Open-Source-Model-Railway-Electronics/OS-Flux/software/Flux-Mobile/changelog.txt

software
v0.0.0   Date/time:2026-02-01 20:26:24.896815
Project assembled
