Open-Source-Model-Railway-Electronics/OS-Flux/hardware/OS-Flux.kicad_pcb

## KiCad design hardware/OS-Flux.kicad_pcb (2026-11-04)

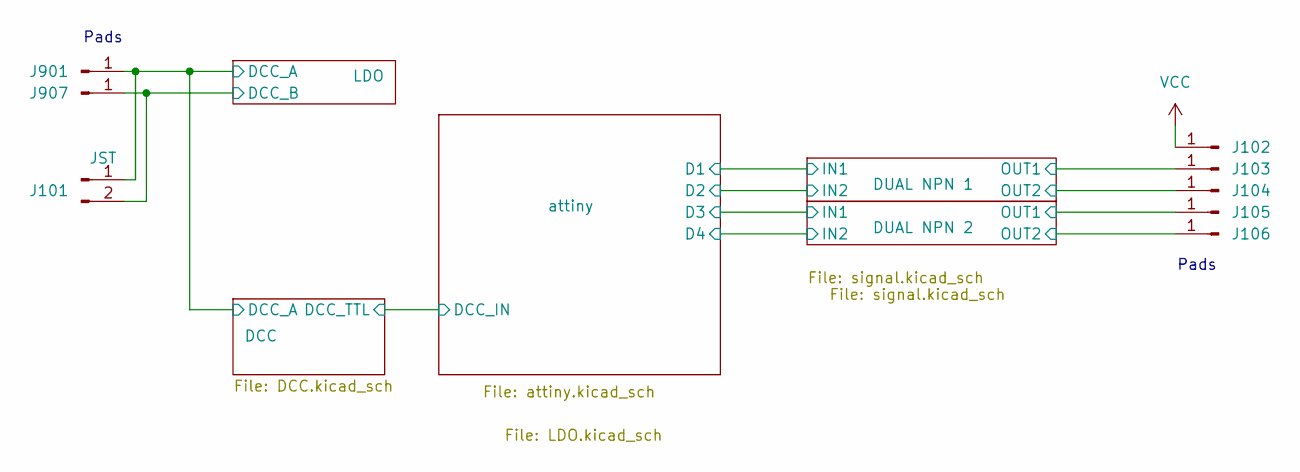
[picture p6: schematic OS-Flux.kicad_sch]

Parts:
J101: JST; JST_SH_SM02B-SRSS-TB_1x02-1MP_P1.00mm_Horizontal
J102, J103, J104, J105, J106, J901, J907: Conn_01x01_Pin; SolderWirePad_1x01_SMD_1x2mm

Connections:
/DCC/DCC_A: J101.1, J901.1; also elsewhere on the board
/DUAL NPN 1/OUT1: J103.1; also elsewhere on the board
/DUAL NPN 1/OUT2: J104.1; also elsewhere on the board
/DUAL NPN 2/OUT1: J105.1; also elsewhere on the board
/DUAL NPN 2/OUT2: J106.1; also elsewhere on the board
/LDO/DCC_B: J101.2, J907.1; also elsewhere on the board
VCC: J102.1; also elsewhere on the board

Notes on the sheet:
Pads

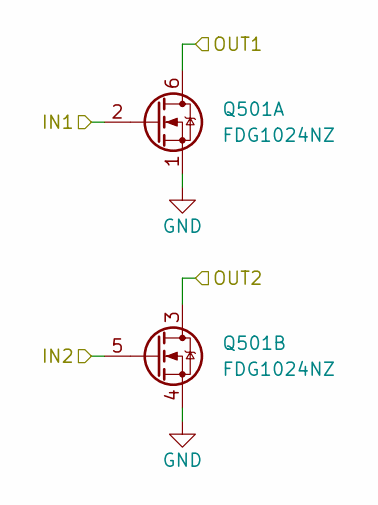
[picture p7: schematic signal.kicad_sch]

Parts:
Q501: FDG1024NZ; SOT-363_SC-70-6; JLCPCB Part# C262138

Connections:
/DUAL NPN 1/IN1: Q501.2 (G); also elsewhere on the board
/DUAL NPN 1/IN2: Q501.5 (G); also elsewhere on the board
/DUAL NPN 1/OUT1: Q501.6 (D); also elsewhere on the board
/DUAL NPN 1/OUT2: Q501.3 (D); also elsewhere on the board
GND: Q501.1 (S), Q501.4 (S); also elsewhere on the board

Parts of its further copies:
Q502: FDG1024NZ; SOT-363_SC-70-6; JLCPCB Part# C262138

Connections of its further copies:
/DUAL NPN 2/OUT1: Q502.6 (D); also elsewhere on the board
/DUAL NPN 2/OUT2: Q502.3 (D); also elsewhere on the board
/attiny/MISO: Q502.2 (G); also elsewhere on the board
/attiny/MOSI: Q502.5 (G); also elsewhere on the board
GND: Q502.1 (S), Q502.4 (S); also elsewhere on the board

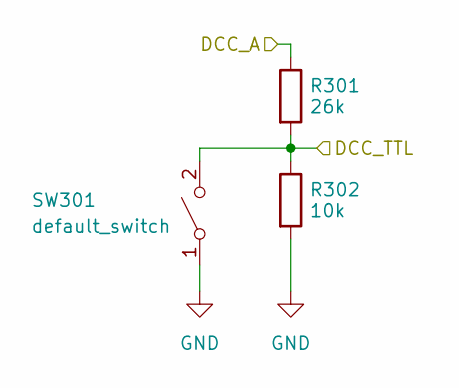
[picture p8: schematic DCC.kicad_sch]

Parts:
R301: 26k; R_0402_1005Metric; JLCPCB Part# C25771
R302: 10k; R_0402_1005Metric; JLCPCB Part# C25744
SW301: default_switch; JLCPCB Part# C318884

Connections:
/attiny/SCK: SW301.2 (B); also elsewhere on the board
GND: SW301.1 (A); also elsewhere on the board

Parts of its further copies:
R2: 26k; R_0402_1005Metric; JLCPCB Part# C25771
R3: 10k; R_0402_1005Metric; JLCPCB Part# C25744

Connections of its further copies:
/DCC/DCC_A: R2.1; also elsewhere on the board
/attiny/SCK: R2.2, R3.1; also elsewhere on the board
GND: R3.2; also elsewhere on the board

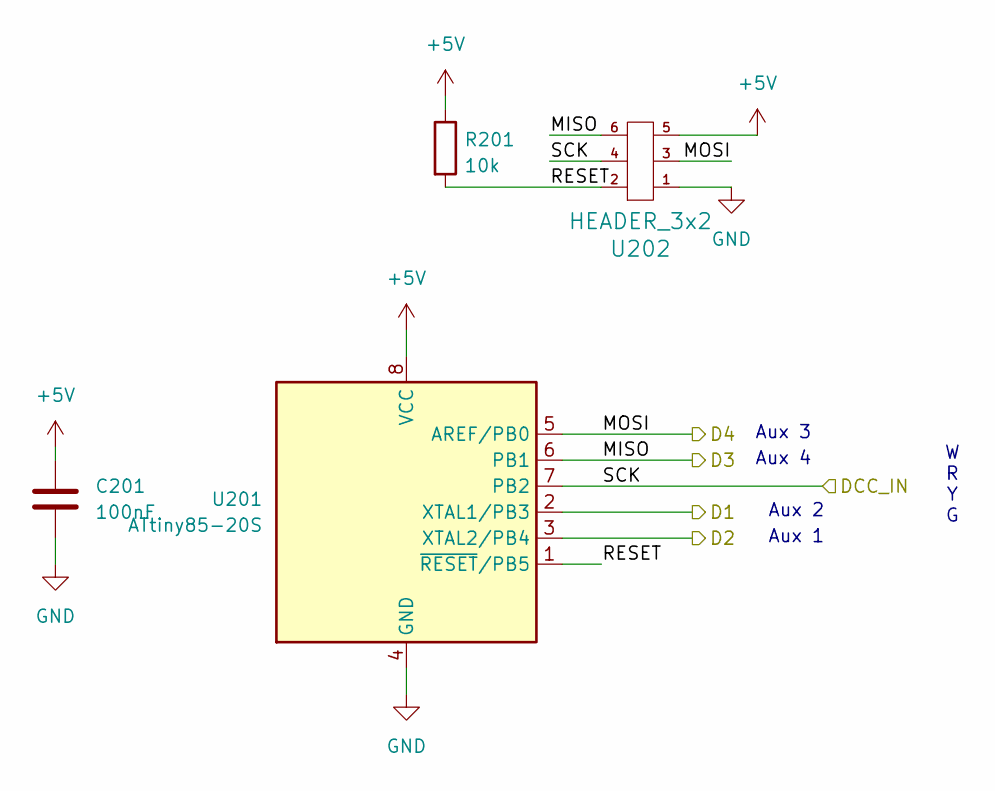
[picture p9: schematic attiny.kicad_sch]

Parts:
C201: 100nF; C_0402_1005Metric; JLCPCB Part# C307331
R201: 10k; R_0402_1005Metric; JLCPCB Part# C25744
U201: ATtiny85-20S; SOIC-8W_5.3x5.3mm_P1.27mm; JLCPCB Part# C615549
U202: HEADER_3x2; PinSocket_2x03_P1.27mm_Vertical

Connections:
+5V: C201.1, R201.1, U201.8 (VCC), U202.5; also elsewhere on the board
/DUAL NPN 1/IN1: U201.2 (XTAL1/PB3); also elsewhere on the board
/DUAL NPN 1/IN2: U201.3 (XTAL2/PB4); also elsewhere on the board
/attiny/MISO: U201.6 (PB1), U202.6; also elsewhere on the board
/attiny/MOSI: U201.5 (AREF/PB0), U202.3; also elsewhere on the board
/attiny/RESET: R201.2, U201.1 (~RESET/PB5), U202.2
/attiny/SCK: U201.7 (PB2), U202.4; also elsewhere on the board
GND: C201.2, U201.4 (GND), U202.1; also elsewhere on the board

Notes on the sheet:
W R Y G
Aux 2
Aux 1
Aux 3
Aux 4

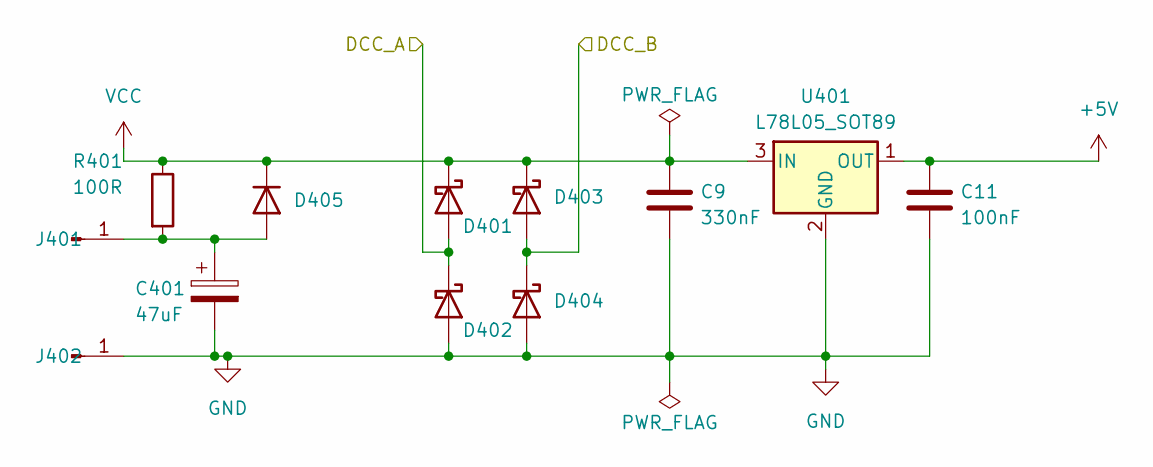
[picture p10: schematic LDO.kicad_sch]

Parts:
C9: 330nF; C_0603_1608Metric; JLCPCB Part# C1615
C11: 100nF; C_0402_1005Metric; JLCPCB Part# C307331
C401: 47uF; CP_EIA-7343-31_Kemet-D; JLCPCB Part# C7228
D401, D402, D403, D404: 1N5819WS; D_SOD-323; JLCPCB Part# C191023
D405: 1N4148WS; D_SOD-323; JLCPCB Part# C2128
J401, J402: Conn_01x01_Pin; SolderWirePad_1x01_SMD_1x2mm
R401: 100R; R_0402_NO_SILK; JLCPCB Part# C25076
U401: L78L05_SOT89; SOT-89-3; JLCPCB Part# C71136

Connections:
+5V: C11.1, U401.1 (OUT); also elsewhere on the board
/DCC/DCC_A: D401.2 (A), D402.1 (K); also elsewhere on the board
/LDO/DCC_B: D403.2 (A), D404.1 (K); also elsewhere on the board
GND: C9.2, C11.2, C401.2, D402.2 (A), D404.2 (A), J402.1, U401.2 (GND); also elsewhere on the board
unnamed: C401.1, D405.2 (A), J401.1, R401.2
VCC: C9.1, D401.1 (K), D403.1 (K), D405.1 (K), R401.1, U401.3 (IN); also elsewhere on the board

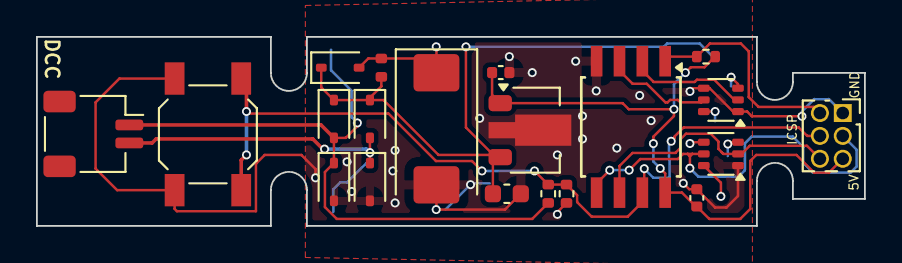
[picture p11: board OS-Flux.kicad_pcb from above]

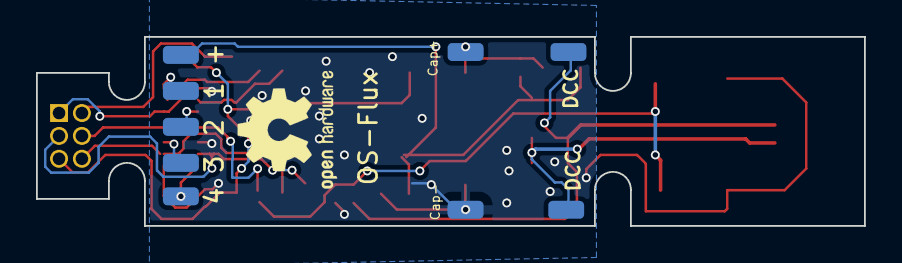
[picture p12: board OS-Flux.kicad_pcb from below]

Board: 2 copper layers, 46.0 x 10.5 mm, 29 parts (9 on the bottom side), 16 nets.
