Open-Source-Model-Railway-Electronics/OS-Flux/(commit log)

2026-11-04 added all files
    [BOM-OS-Flux.csv, DCC.kicad_sch, LDO.kicad_sch, OS-Flux.kicad_pcb, OS-Flux.kicad_sch, attiny.kicad_sch, signal.kicad_sch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]
2026-11-04 Stop tracking releases folder, fix ignore pattern
    [BOM-OS-Flux.csv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]
2026-11-04 Add README and manual translations in 12 languages
    Language bar added to Manual-EN.md; DE/FR/NL/ES/IT/PL/CS/DA/NO/SV/HU/PT
    translations with model-railway terminology checked against local
    forums and manufacturer manuals.
